PhelanDev/PHELAN_butterfly_two/Dimension_A1_print_Phelan_butterfly_ 80cm.pdf

# Phelan Butterfly

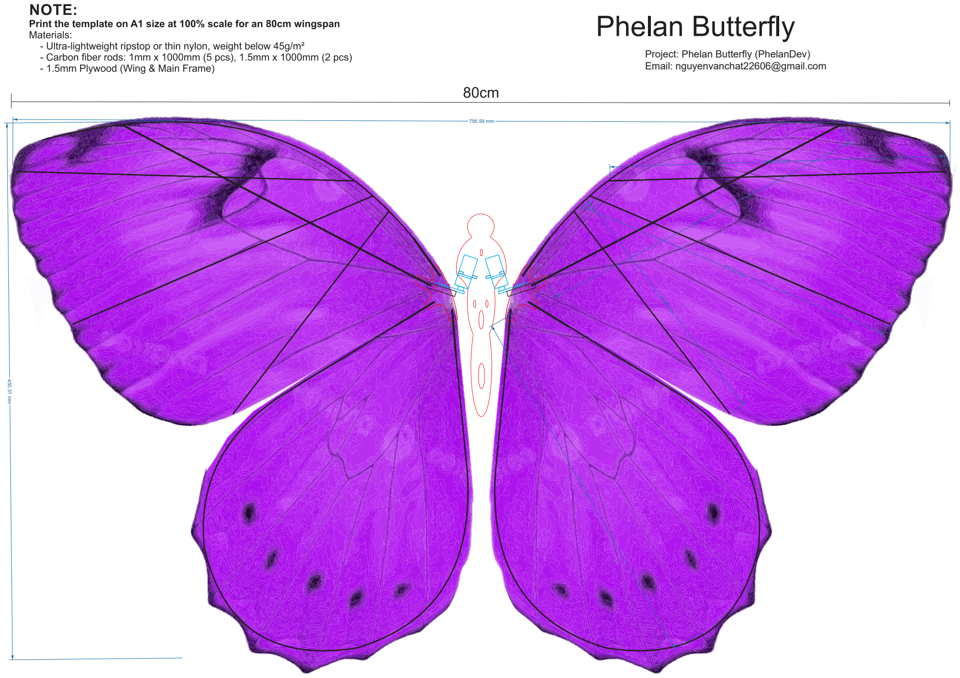
[picture p1: page 1]

Project: Phelan Butterfly (PhelanDev)
Email: nguyenvanchat22606@gmail.com
