PhelanDev/PHELAN_butterfly_two/servo_sys.cpp

#include "servo_sys.h"

namespace ServoSystem {
Control state;

void attachAll() {
  if (!state.isAttached) {
    state.left.setPeriodHertz(Config::SERVO_HZ);
    state.right.setPeriodHertz(Config::SERVO_HZ);
    state.left.attach(Config::SERVO_L_PIN, 500, 2500);
    state.right.attach(Config::SERVO_R_PIN, 500, 2500);
    int outL =
        Config::REVERSE_SERVO_L ? (180 - state.lastPosL) : state.lastPosL;
    int outR =
        Config::REVERSE_SERVO_R ? (180 - state.lastPosR) : state.lastPosR;
    state.left.write(outL);
    state.right.write(outR);
    state.filteredL = (int32_t)state.lastPosL << Config::SERVO_EMA_ALPHA_SHIFT;
    state.filteredR = (int32_t)state.lastPosR << Config::SERVO_EMA_ALPHA_SHIFT;
    state.isAttached = true;
  }
}

void detachAll() {
  if (state.isAttached) {
    state.left.detach();
    state.right.detach();
    state.isAttached = false;
  }
}

void update(int targetL, int targetR, bool bypassFilter) {
  if (!state.isAttached)
    return;
  targetL =
      constrain(targetL, Config::SERVO_MIN_ANGLE, Config::SERVO_MAX_ANGLE);
  targetR =
      constrain(targetR, Config::SERVO_MIN_ANGLE, Config::SERVO_MAX_ANGLE);

  if (bypassFilter) {
    state.filteredL = (int32_t)targetL << Config::SERVO_EMA_ALPHA_SHIFT;
    state.filteredR = (int32_t)targetR << Config::SERVO_EMA_ALPHA_SHIFT;
  } else {
    state.filteredL +=
        targetL - (state.filteredL >> Config::SERVO_EMA_ALPHA_SHIFT);
    state.filteredR +=
        targetR - (state.filteredR >> Config::SERVO_EMA_ALPHA_SHIFT);
  }

  targetL = state.filteredL >> Config::SERVO_EMA_ALPHA_SHIFT;
  targetR = state.filteredR >> Config::SERVO_EMA_ALPHA_SHIFT;

  if (abs(targetL - state.lastPosL) >= 2) {
    int outL = Config::REVERSE_SERVO_L ? (180 - targetL) : targetL;
    state.left.write(outL);
    state.lastPosL = targetL;
  }
  if (abs(targetR - state.lastPosR) >= 2) {
    int outR = Config::REVERSE_SERVO_R ? (180 - targetR) : targetR;
    state.right.write(outR);
    state.lastPosR = targetR;
  }
}
}
