PhelanDev/PHELAN_butterfly_two/(commit log)

2026-10-04 feat: initial release - ESP32 flapping-wing flight controller with Tactical Web Deck
2026-10-04 chore: remove decorative emoji and AI-slop from README and code comments
    [buomv1.ino]
2026-10-04 docs(readme): specify PTK 7452 servos and 2S LiPo with 5V BEC power architecture
