PhelanDev/PHELAN_butterfly_two/(notices)

Notices in the files:
README.md:
License: MIT
